G4TGJ/FreqGen5351/PCB/5VRegulatorComponents.pdf

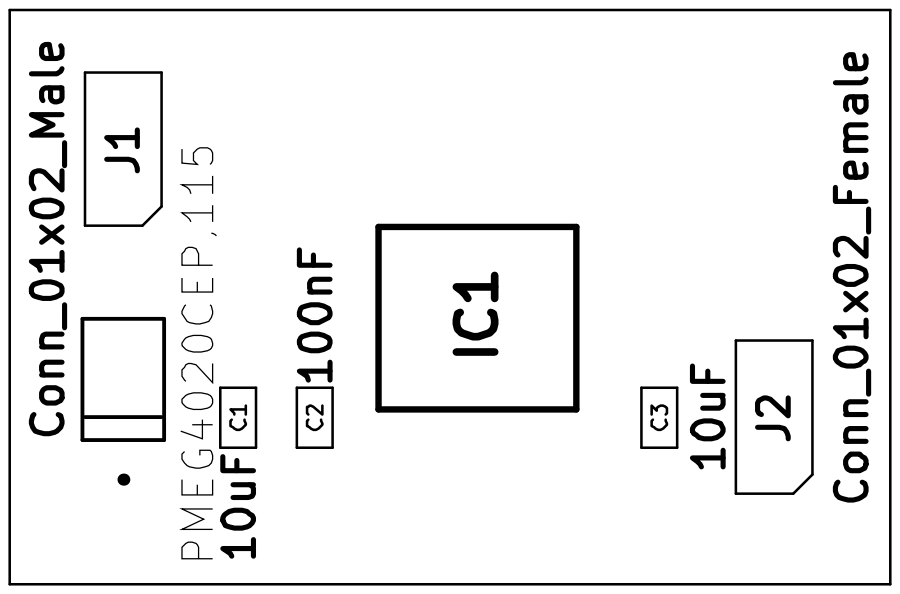
[picture p1: page 1]
