G4TGJ/FreqGen5351/PCB/Components.pdf

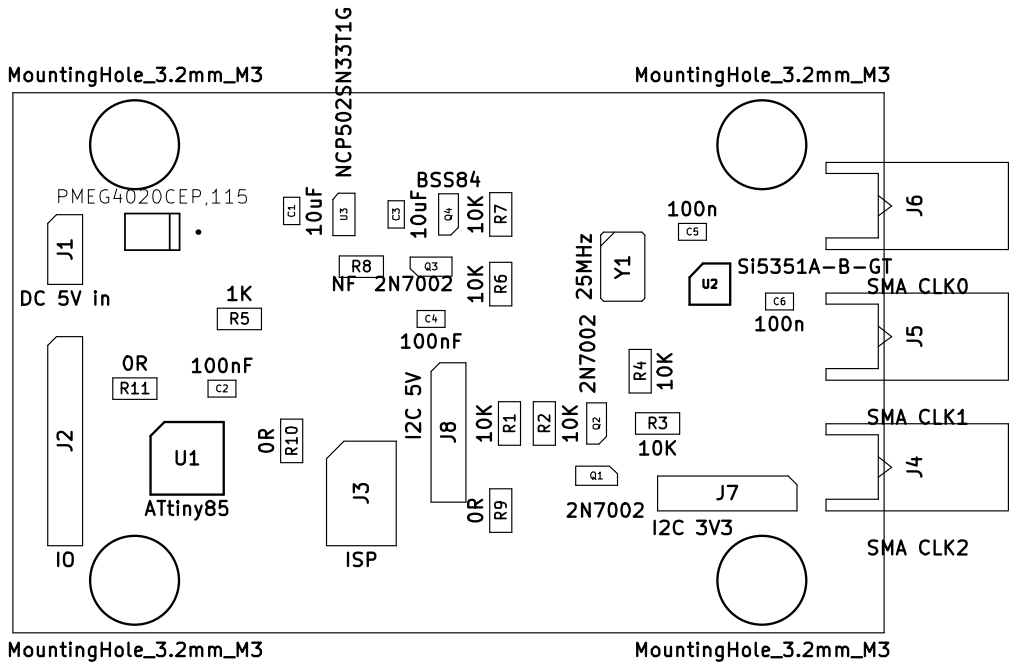
[picture p2: page 1]
