G4TGJ/FreqGen5351/PCB/5VRegulatorMirror.pdf

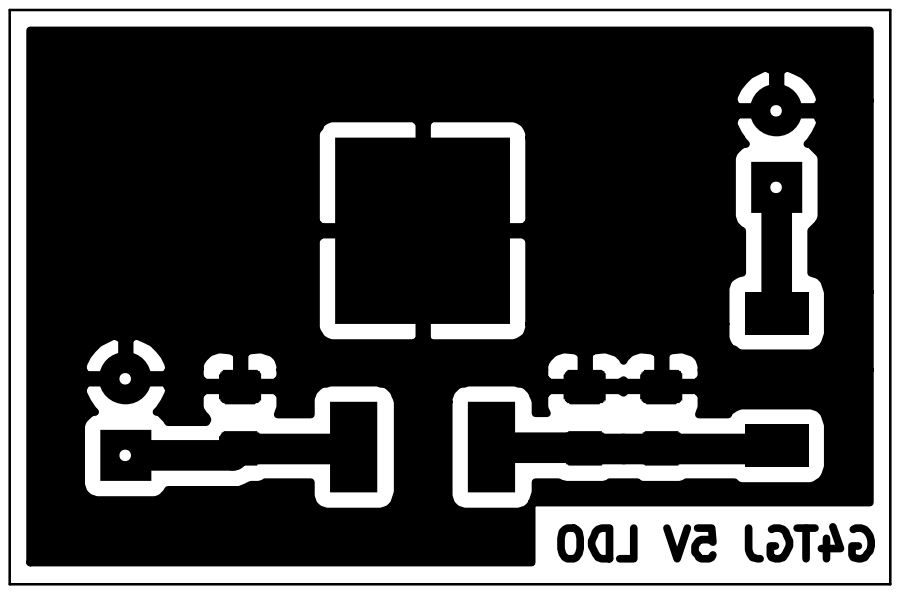
[picture p3: page 1]
