G4TGJ/FreqGen5351/PCB/Bottom.pdf

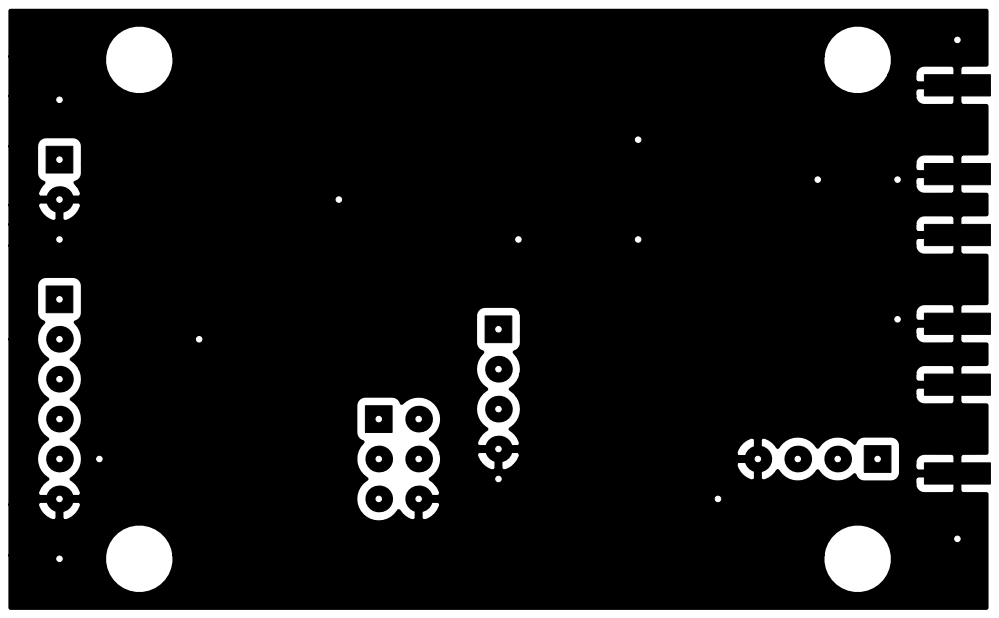
[picture p4: page 1]
