G4TGJ/FreqGen5351/PCB/Top.pdf

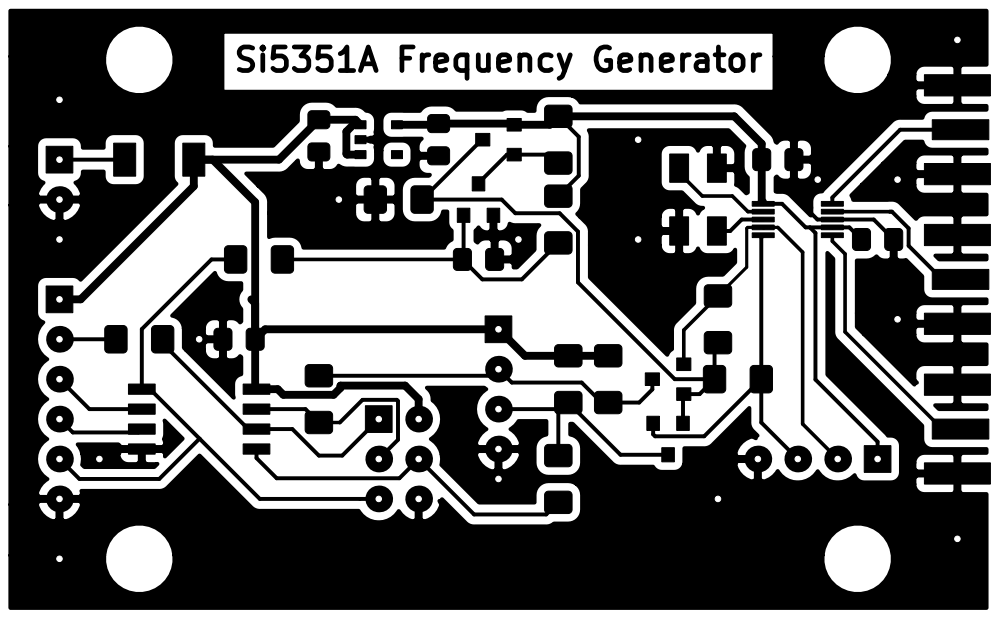
[picture p5: page 1]
