G4TGJ/FreqGen5351/PCB/TopMirror.pdf

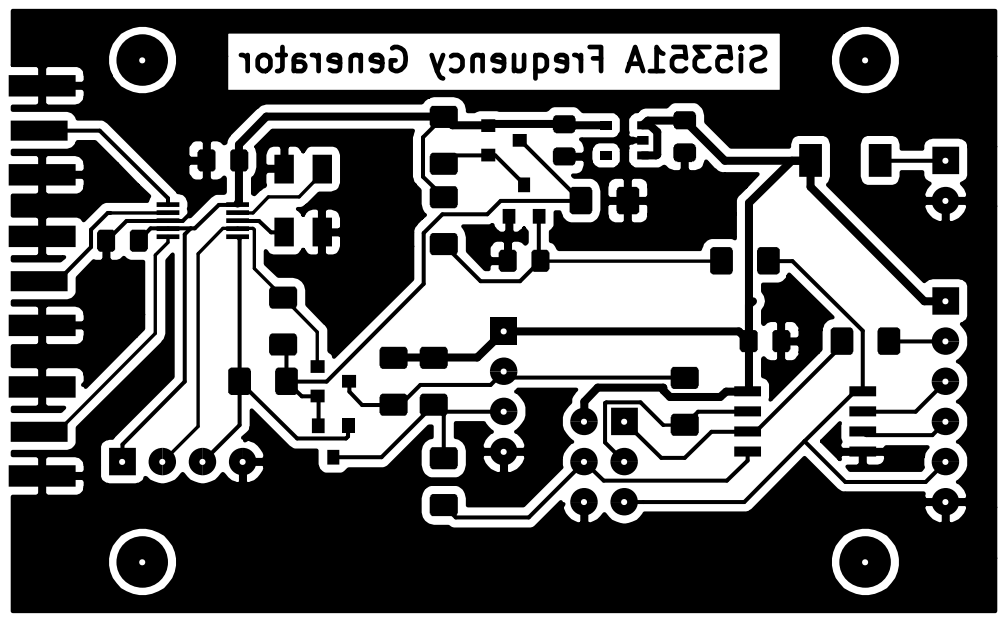
[picture p6: page 1]
