G4TGJ/FreqGen5351/(commit log)

2020-07-03 Lowered crystal load capacitance
2020-07-10 Swapped rotary pins to suit final hardware.
    [config.h]
2020-08-22 Docker image name must be lower case
2020-08-24 Remove setting clock to 8MHz
    Setting the clock to 8MHz in software causes the USBasp clone to struggle to read or write. This is probably due to the USBasp clock speed detection algorithm getting confused with the changing speed.
    Instead will require the CKDIV8 fuse to be unprogrammed.
2020-08-30 Set default outputs to those for calibration
2020-08-30 Add calibration EEPROM file
2020-09-26 Rotary now needs pushbutton driver
2020-10-16 Add PCB files
2022-09-11 Add superhet VFO mode
    Clock 2 should be zero for quadrature VFO or the filter centre frequency for superhet VFO.
